algofoogle/gf180ws2rbz/README.md

# gf180ws2rbz: Raybox-zero supporting materials

For now, this is just a test PCB for various parts that could be used to support a raybox-zero devkit.
