algofoogle/gf180ws2rbz/docs/wafer_space_1x0p5_padring.pdf

# Wafer.Space GF180 Run 2 — Raybox Zero 1×0.5 Padring

## GDS-derived to-scale pad geometry · top view · TEX_PMOD_TYPE=1 mode

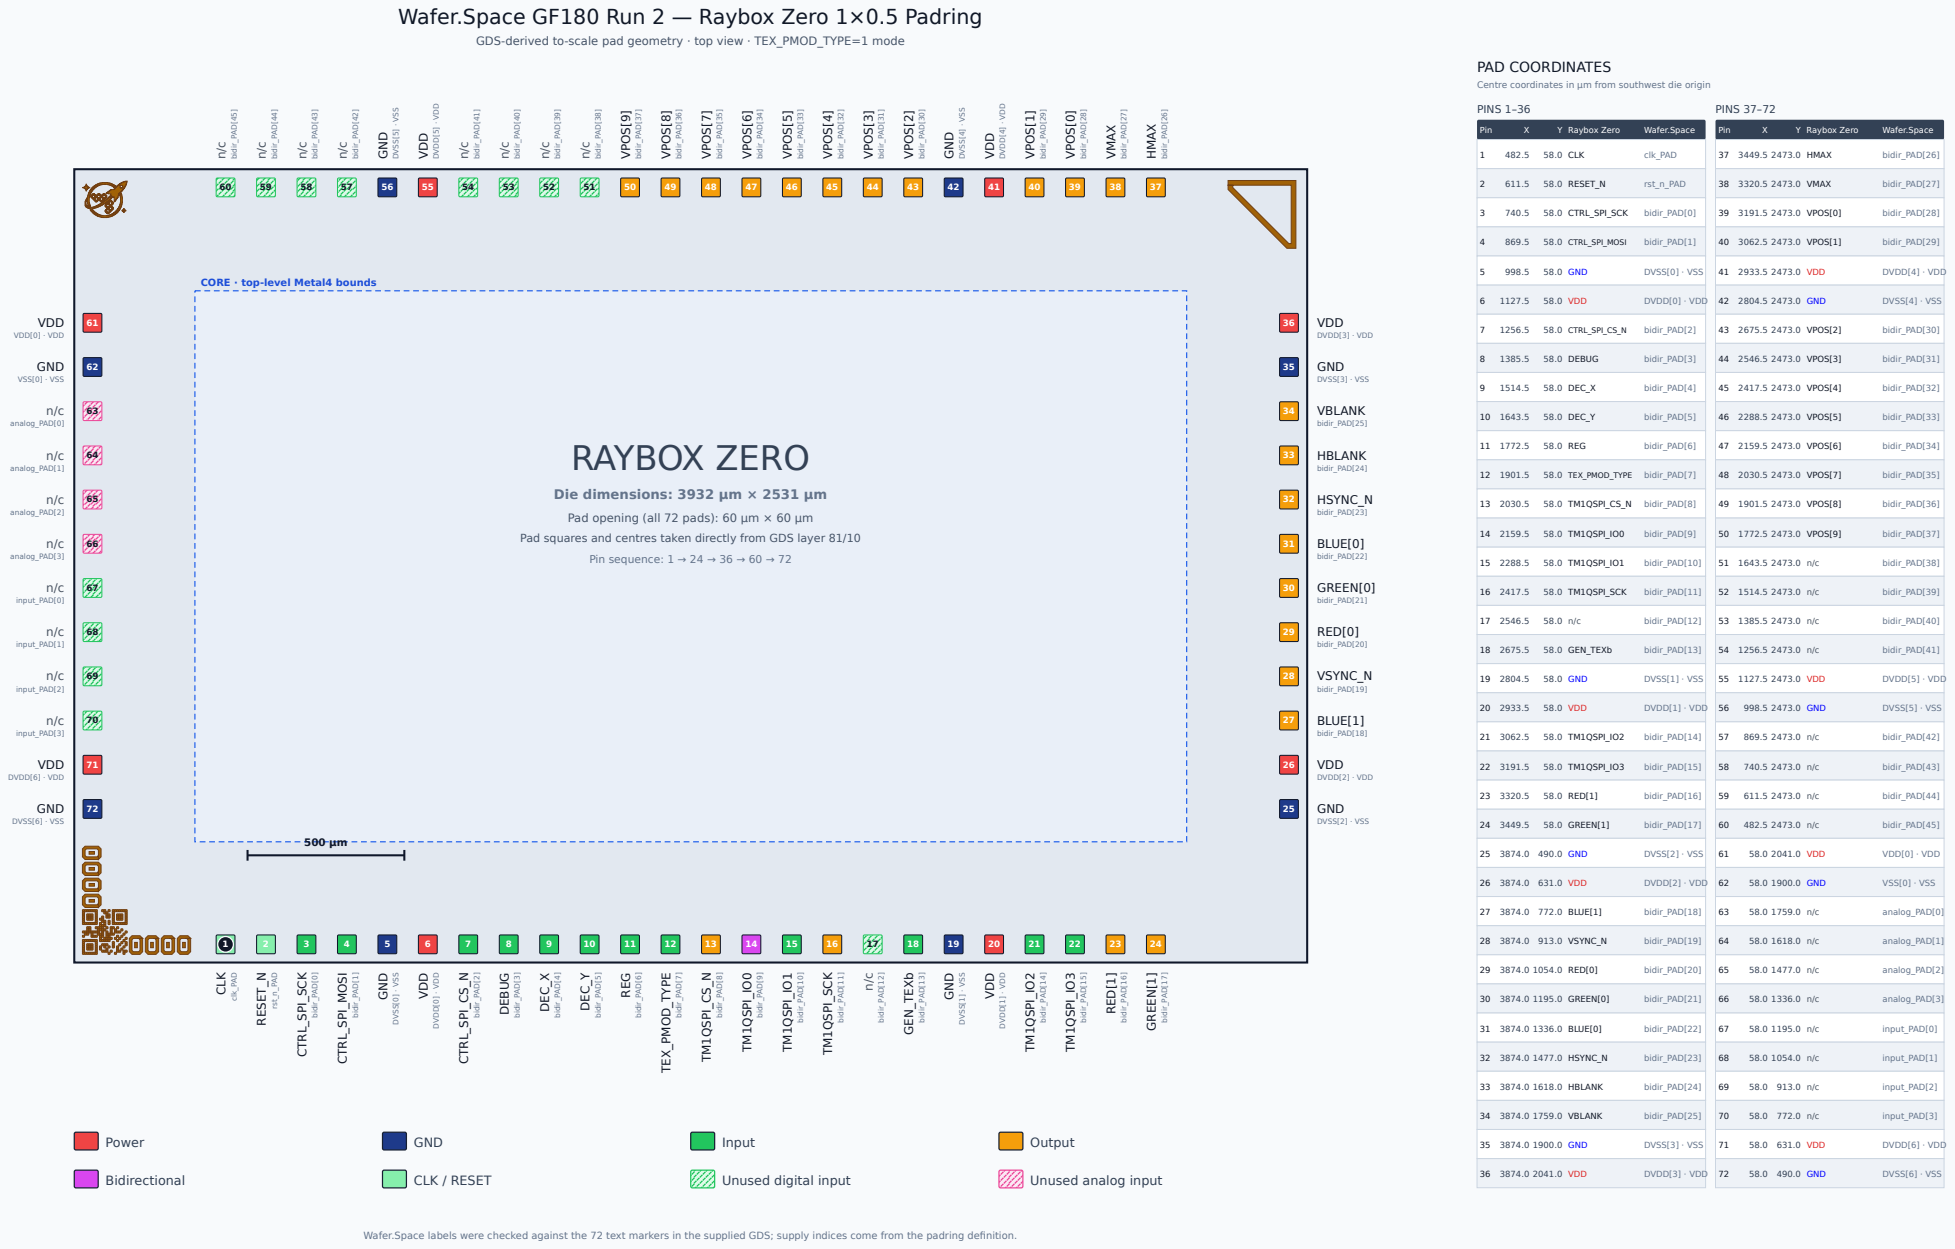
[picture p3: page 1]
1CLK; clk_PAD; 2RESET_N; rst_n_PAD; 3CTRL_SPI_SCK; bidir_PAD[0]; 4CTRL_SPI_MOSI; bidir_PAD[1]; 5GND; DVSS[0] · VSS; 6VDD; DVDD[0] · VDD; 7CTRL_SPI_CS_N; bidir_PAD[2]; 8DEBUG; bidir_PAD[3]; 9DEC_X; bidir_PAD[4]; 10DEC_Y bidir_PAD[5]; 11REG; bidir_PAD[6]; 12TEX_PMOD_TYPE; bidir_PAD[7]; 13TM¹QSPI_CS_N; bidir_PAD[8]; 14TM¹QSPI_IO⁰ bidir_PAD[9]; 15TM¹QSPI_IO¹; bidir_PAD[10]; 16TM¹QSPI_SCK bidir_PAD[11]; bidir_PAD[12]; 18GEN_TEXb; bidir_PAD[13]; 19GND; DVSS[1] · VSS; 20VDD DVDD[1] · VDD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

Centre coordinates in µm from southwest die origin

CORE · top-level Metal4 bounds

Die dimensions: 3932 µm × 2531 µm
Pad opening (all 72 pads): 60 µm × 60 µm

Pad squares and centres taken directly from GDS layer 81/10

Wafer.Space labels were checked against the 72 text markers in the supplied GDS; supply indices come from the padring definition.
