algofoogle/gf180ws2rbz/gf180ws2rbz_parts_test/gf180ws2rbz_parts_test.kicad_pcb

## KiCad design gf180ws2rbz_parts_test/gf180ws2rbz_parts_test.kicad_pcb (2026-11-12)

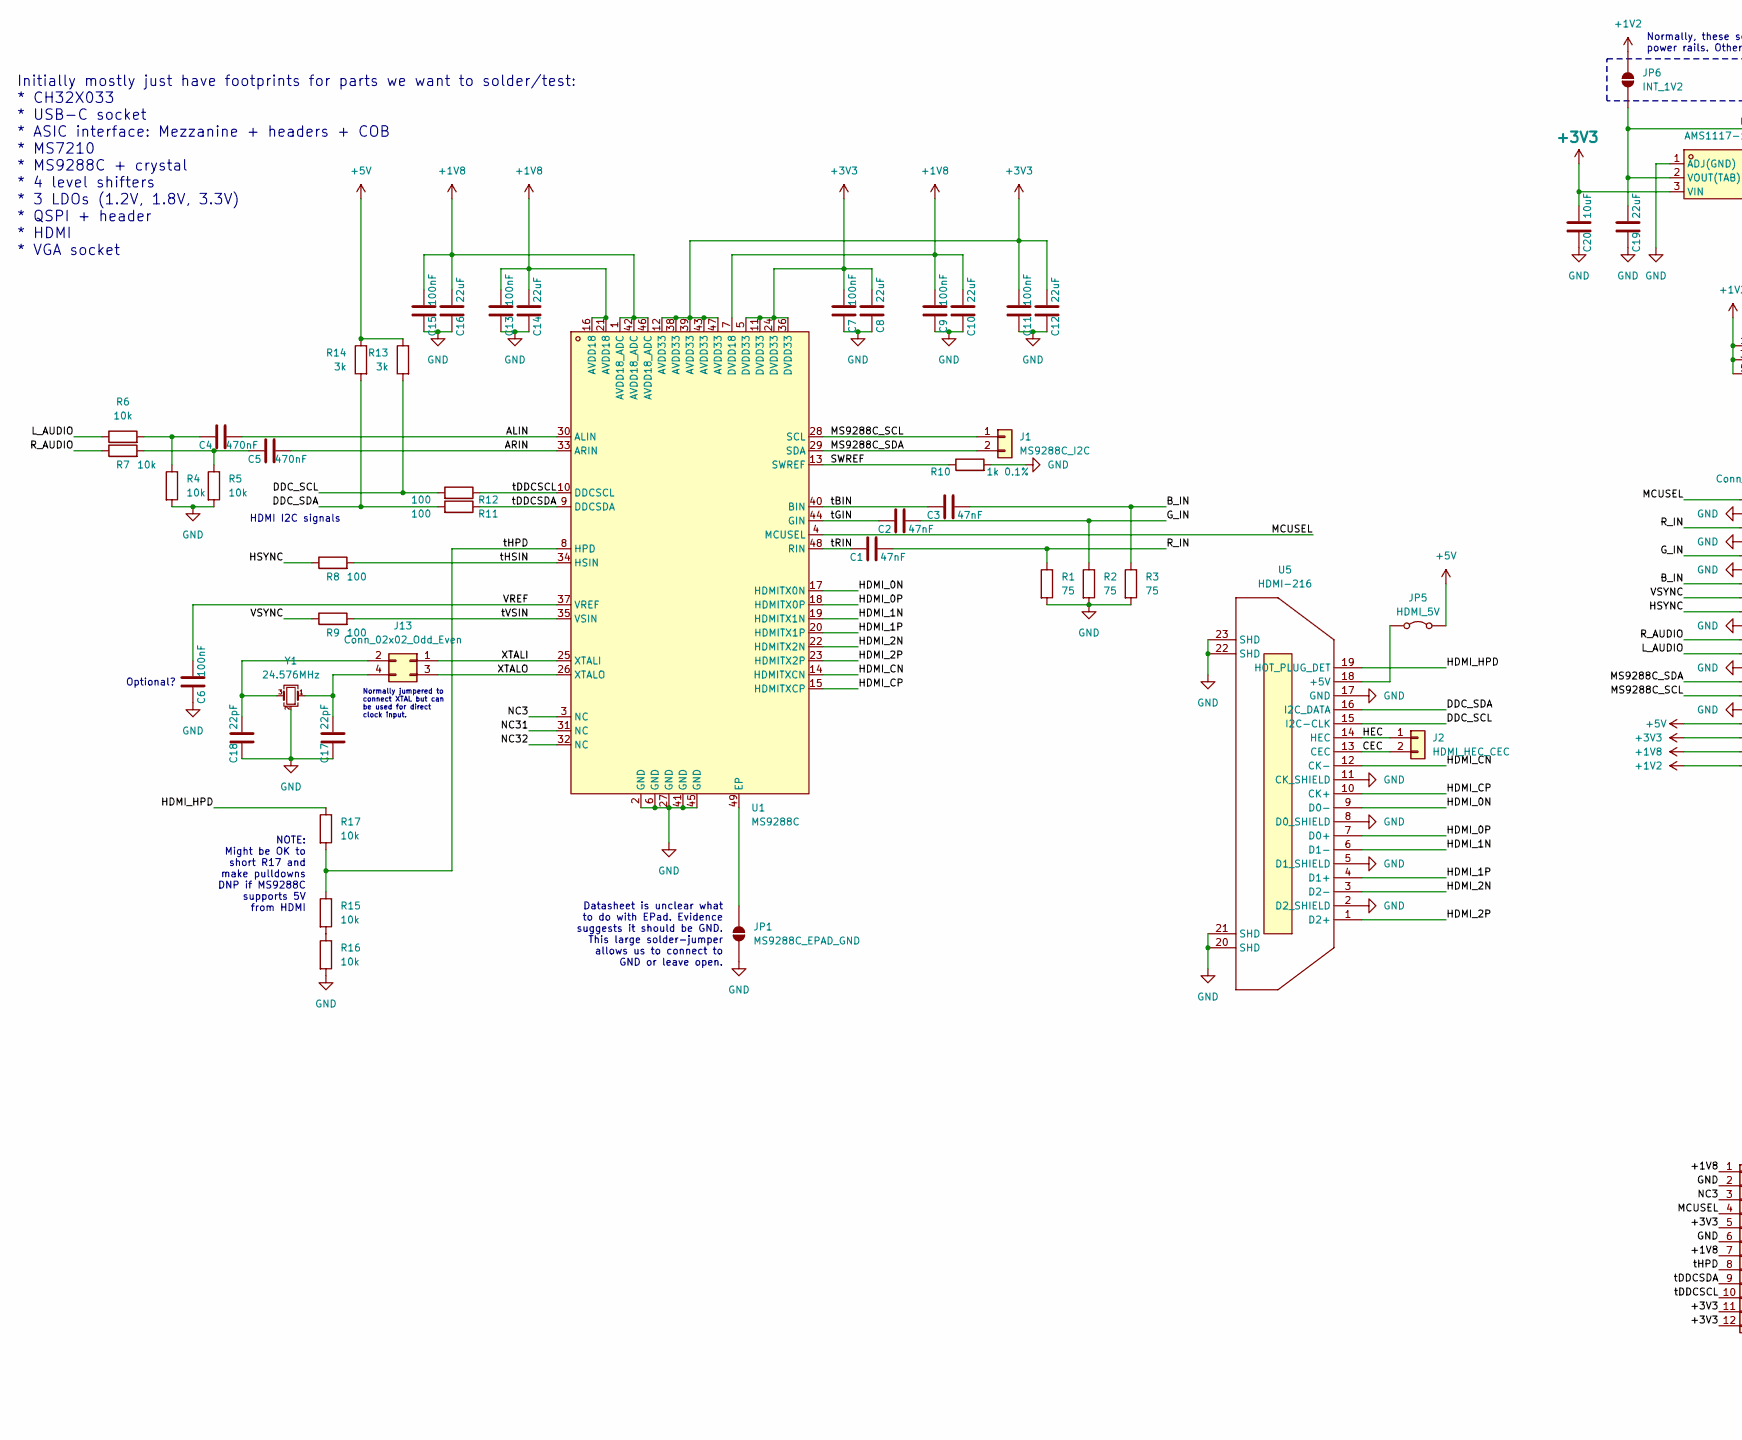
[picture p4: schematic gf180ws2rbz_parts_test.kicad_sch, part in row 1, column 1]

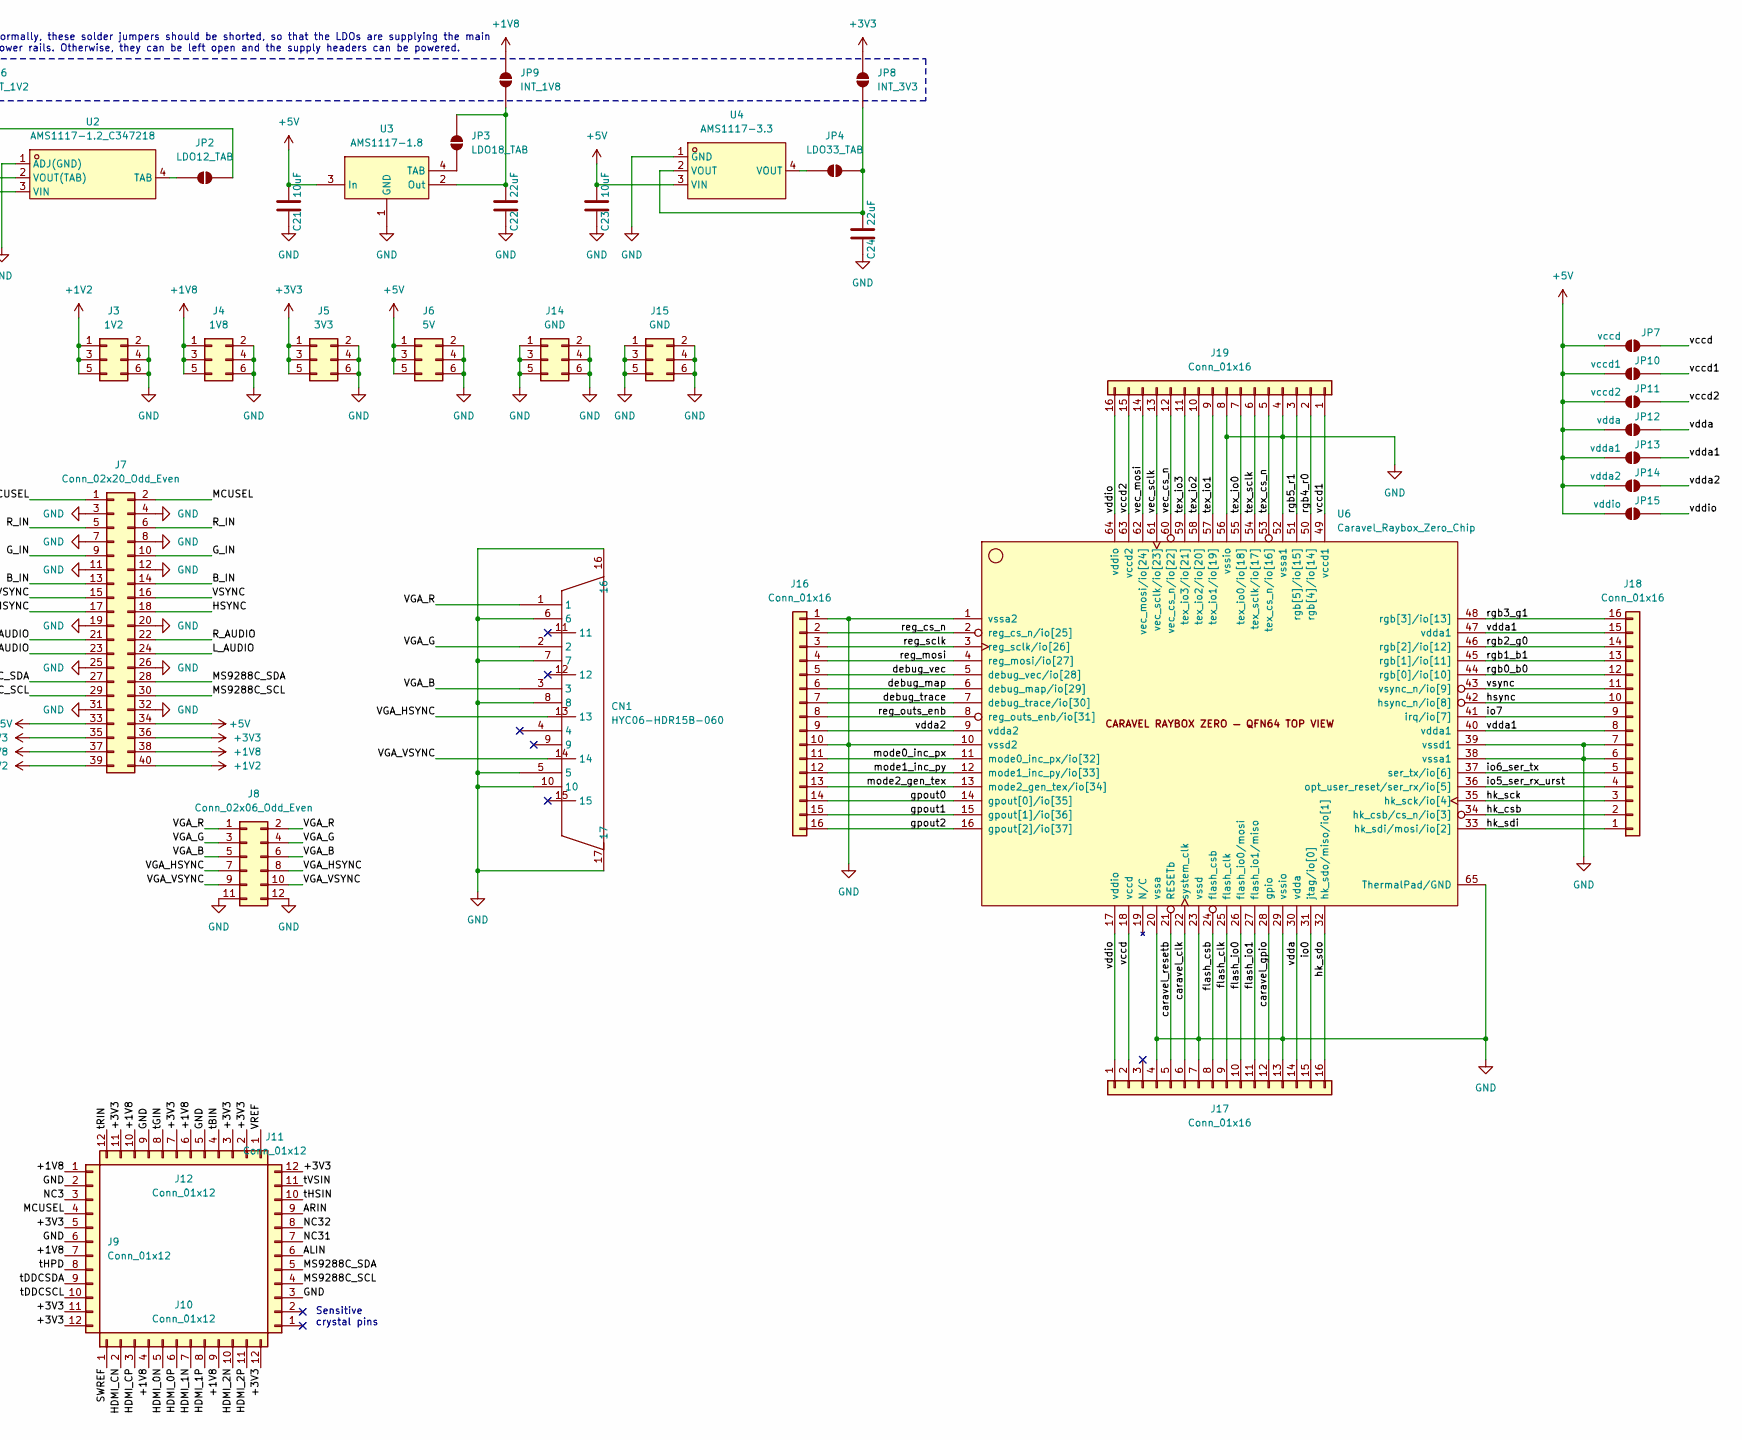
[picture p5: schematic gf180ws2rbz_parts_test.kicad_sch, part in row 1, column 2]

Parts:
C1, C2, C3: 47nF; C_0603_1608Metric_Pad1.08x0.95mm_HandSolder
C4, C5: 470nF; C_0603_1608Metric_Pad1.08x0.95mm_HandSolder
C6, C7, C9, C11, C13, C15: 100nF; C_0603_1608Metric_Pad1.08x0.95mm_HandSolder
C8, C10, C12, C14, C16, C19, C22, C24: 22uF; C_0603_1608Metric_Pad1.08x0.95mm_HandSolder
C17, C18: 22pF; C_0603_1608Metric_Pad1.08x0.95mm_HandSolder
C20, C21, C23: 10uF; C_0603_1608Metric_Pad1.08x0.95mm_HandSolder
CN1: HYC06-HDR15B-060; DSUB-TH_HYC06-HDR15B-060; MPN HYC06-HDR15B-060; LCSC Part C711364
J1: MS9288C_I2C; PinHeader_1x02_P2.54mm_Vertical
J2: HDMI_HEC_CEC; PinHeader_1x02_P2.54mm_Vertical
J3: 1V2; PinHeader_2x03_P2.54mm_Vertical
J4: 1V8; PinHeader_2x03_P2.54mm_Vertical
J5: 3V3; PinHeader_2x03_P2.54mm_Vertical
J6: 5V; PinHeader_2x03_P2.54mm_Vertical
J7: Conn_02x20_Odd_Even; PinHeader_2x20_P2.54mm_Vertical
J8: Conn_02x06_Odd_Even; PinHeader_2x06_P2.54mm_Vertical
J9, J10, J11, J12: Conn_01x12; AntonPTHTestPointStagger12way
J13: Conn_02x02_Odd_Even; Anton-PinSocket_2x02_P2.54mm_Vertical-SolderJumper
J14, J15: GND; PinHeader_2x03_P2.54mm_Vertical
J16, J17, J18, J19: Conn_01x16; Anton_Pads_01x16_1.27mm_Compact_SMD
JP1: MS9288C_EPAD_GND; SolderJumper-2_P1.3mm_Open_RoundedPad1.0x1.5mm
JP2: LDO12_TAB; SolderJumper-2_P1.3mm_Open_RoundedPad1.0x1.5mm
JP3: LDO18_TAB; SolderJumper-2_P1.3mm_Open_RoundedPad1.0x1.5mm
JP4: LDO33_TAB; SolderJumper-2_P1.3mm_Open_RoundedPad1.0x1.5mm
JP5: HDMI_5V; Anton-PinHeader_1x02_P2.54mm_Vertical-SolderJumper
JP6: INT_1V2; SolderJumper-2_P1.3mm_Open_RoundedPad1.0x1.5mm
JP7: vccd; SolderJumper-2_P1.3mm_Open_RoundedPad1.0x1.5mm
JP8: INT_3V3; SolderJumper-2_P1.3mm_Open_RoundedPad1.0x1.5mm
JP9: INT_1V8; SolderJumper-2_P1.3mm_Open_RoundedPad1.0x1.5mm
JP10: vccd1; SolderJumper-2_P1.3mm_Open_RoundedPad1.0x1.5mm
JP11: vccd2; SolderJumper-2_P1.3mm_Open_RoundedPad1.0x1.5mm
JP12: vdda; SolderJumper-2_P1.3mm_Open_RoundedPad1.0x1.5mm
JP13: vdda1; SolderJumper-2_P1.3mm_Open_RoundedPad1.0x1.5mm
JP14: vdda2; SolderJumper-2_P1.3mm_Open_RoundedPad1.0x1.5mm
JP15: vddio; SolderJumper-2_P1.3mm_Open_RoundedPad1.0x1.5mm
R1, R2, R3: 75; R_0603_1608Metric_Pad0.98x0.95mm_HandSolder
R4, R5, R6, R7, R15, R16, R17: 10k; R_0603_1608Metric_Pad0.98x0.95mm_HandSolder
R8, R9, R11, R12: 100; R_0603_1608Metric_Pad0.98x0.95mm_HandSolder
R10: 1k 0.1%; R_0603_1608Metric_Pad0.98x0.95mm_HandSolder
R13, R14: 3k; R_0603_1608Metric_Pad0.98x0.95mm_HandSolder
U1: MS9288C; Anton-QFN-48_L6-W6-P0.4-TL-EP4.2-HandSolder; MPN MS9288C; LCSC Part C2914316
U2: AMS1117-1.2_C347218; SOT-223_L6.7-W3.5-P2.30-BR; MPN AMS1117-1.2; LCSC Part C347218
U3: AMS1117-1.8; SOT-223-4_L6.5-W3.5-P2.30-LS7.0-BR; MPN AMS1117-1.8; LCSC Part C6185
U4: AMS1117-3.3; SOT-223-3_L6.5-W3.4-P2.30-LS7.0-BR; MPN AMS1117-3.3; LCSC Part C6186
U5: HDMI-216; HDMI-SMD_KH-HDMI-19P-CU; MPN HDMI-216; LCSC Part C2962407
U6: Caravel_Raybox_Zero_Chip; Anton-QFN-64-1EP_9x9mm_P0.5mm_EP7.65x7.65mm-HOLE
Y1: 24.576MHz; Crystal_SMD_EuroQuartz_MT-4Pin_3.2x2.5mm_HandSoldering; PartNum XTM32024576JT00351001; LCSC_PartNum C41383247

Connections:
+1V2: J3.1, J3.3, J3.5, J7.39, J7.40, JP6.1 (A)
+1V8: C9.2, C10.2, C13.2, C14.2, C15.2, C16.2, J4.1, J4.3, J4.5, J7.37, J7.38, J9.1, J9.7, J10.4, J10.9, J12.6, J12.10, JP9.1 (A), U1.1 (AVDD18_ADC), U1.7 (DVDD18), U1.16 (AVDD18), U1.21 (AVDD18), U1.42 (AVDD18_ADC), U1.46 (AVDD18_ADC)
+3V3: C7.2, C8.2, C11.2, C12.2, C20.2, J5.1, J5.3, J5.5, J7.35, J7.36, J9.5, J9.11, J9.12, J10.12, J11.12, J12.2, J12.3, J12.7, J12.11, JP8.1 (A), U1.5 (DVDD33), U1.11 (DVDD33), U1.12 (AVDD33), U1.24 (DVDD33), U1.36 (DVDD33), U1.38 (AVDD33), U1.39 (AVDD33), U1.43 (AVDD33), U1.47 (AVDD33), U2.3 (VIN)
/ALIN: C4.2, J11.6, U1.30 (ALIN)
/ARIN: C5.2, J11.9, U1.33 (ARIN)
/CEC: J2.2, U5.13 (CEC)
/DDC_SCL: R12.2, R13.2, U5.15 (I2C-CLK)
/DDC_SDA: R11.2, R14.2, U5.16 (I2C_DATA)
/HDMI_0N: J10.5, U1.17 (HDMITX0N), U5.9 (D0-)
/HDMI_0P: J10.6, U1.18 (HDMITX0P), U5.7 (D0+)
/HDMI_1N: J10.7, U1.19 (HDMITX1N), U5.6 (D1-)
/HDMI_1P: J10.8, U1.20 (HDMITX1P), U5.4 (D1+)
/HDMI_2N: J10.10, U1.22 (HDMITX2N), U5.3 (D2-)
/HDMI_2P: J10.11, U1.23 (HDMITX2P), U5.1 (D2+)
/HDMI_CN: J10.2, U1.14 (HDMITXCN), U5.12 (CK-)
/HDMI_CP: J10.3, U1.15 (HDMITXCP), U5.10 (CK+)
/HDMI_HPD: R17.1, U5.19 (HOT_PLUG_DET)
/HEC: J2.1, U5.14 (HEC)
/HSYNC: J7.17, J7.18, R8.1; also elsewhere on the board
/L_AUDIO: J7.23, J7.24, R6.1
/MCUSEL: J7.1, J7.2, J9.4, U1.4 (MCUSEL)
/MS9288C_SCL: J1.1, J7.29, J7.30, J11.4, U1.28 (SCL)
/MS9288C_SDA: J1.2, J7.27, J7.28, J11.5, U1.29 (SDA)
/NC3: J9.3, U1.3 (NC)
/NC31: J11.7, U1.31 (NC)
/NC32: J11.8, U1.32 (NC)
/R_AUDIO: J7.21, J7.22, R7.1
/SWREF: J10.1, R10.1, U1.13 (SWREF)
/VGA_HSYNC: CN1.13, J8.7, J8.8; also elsewhere on the board
/VGA_VSYNC: CN1.14, J8.9, J8.10; also elsewhere on the board
/VREF: C6.2, J12.1, U1.37 (VREF)
/VSYNC: J7.15, J7.16, R9.1; also elsewhere on the board
/XTALI: J13.1, U1.25 (XTALI)
/XTALO: J13.3, U1.26 (XTALO)
/caravel_clk: J17.6, U6.22 (system_clk)
/caravel_gpio: J17.12, U6.28 (gpio)
/caravel_resetb: J17.5, U6.21 (RESETb)
/debug_map: J16.6, U6.6 (debug_map/io[29])
/debug_trace: J16.7, U6.7 (debug_trace/io[30])
/debug_vec: J16.5, U6.5 (debug_vec/io[28])
/flash_clk: J17.9, U6.25 (flash_clk)
/flash_csb: J17.8, U6.24 (flash_csb)
/flash_io0: J17.10, U6.26 (flash_io0/mosi)
/flash_io1: J17.11, U6.27 (flash_io1/miso)
/gpout0: J16.14, U6.14 (gpout[0]/io[35])
/gpout1: J16.15, U6.15 (gpout[1]/io[36])
/gpout2: J16.16, U6.16 (gpout[2]/io[37])
/hk_csb: J18.2, U6.34 (hk_csb/cs_n/io[3])
/hk_sck: J18.3, U6.35 (hk_sck/io[4])
/hk_sdi: J18.1, U6.33 (hk_sdi/mosi/io[2])
/hk_sdo: J17.16, U6.32 (hk_sdo/miso/io[1])
/hsync: J18.10, U6.42 (hsync_n/io[8])
/io0: J17.15, U6.31 (jtag/io[0])
/io5_ser_rx_urst: J18.4, U6.36 (opt_user_reset/ser_rx/io[5])
/io6_ser_tx: J18.5, U6.37 (ser_tx/io[6])
/io7: J18.9, U6.41 (irq/io[7])
/mode0_inc_px: J16.11, U6.11 (mode0_inc_px/io[32])
/mode1_inc_py: J16.12, U6.12 (mode1_inc_py/io[33])
/mode2_gen_tex: J16.13, U6.13 (mode2_gen_tex/io[34])
/reg_cs_n: J16.2, U6.2 (reg_cs_n/io[25])
/reg_mosi: J16.4, U6.4 (reg_mosi/io[27])
/reg_outs_enb: J16.8, U6.8 (reg_outs_enb/io[31])
/reg_sclk: J16.3, U6.3 (reg_sclk/io[26])
/rgb0_b0: J18.12, U6.44 (rgb[0]/io[10])
/rgb1_b1: J18.13, U6.45 (rgb[1]/io[11])
/rgb2_g0: J18.14, U6.46 (rgb[2]/io[12])
/rgb3_g1: J18.16, U6.48 (rgb[3]/io[13])
/rgb4_r0: J19.2, U6.50 (rgb[4]/io[14])
/rgb5_r1: J19.3, U6.51 (rgb[5]/io[15])
/tBIN: C3.1, J12.4, U1.40 (BIN)
/tDDCSCL: J9.10, R12.1, U1.10 (DDCSCL)
/tDDCSDA: J9.9, R11.1, U1.9 (DDCSDA)
/tGIN: C2.1, J12.8, U1.44 (GIN)
/tHPD: J9.8, R15.1, R17.2, U1.8 (HPD)
/tHSIN: J11.10, R8.2, U1.34 (HSIN)
/tRIN: C1.1, J12.12, U1.48 (RIN)
/tVSIN: J11.11, R9.2, U1.35 (VSIN)
/tex_cs_n: J19.5, U6.53 (tex_cs_n/io[16])
/tex_io0: J19.7, U6.55 (tex_io0/io[18])
/tex_io1: J19.9, U6.57 (tex_io1/io[19])
/tex_io2: J19.10, U6.58 (tex_io2/io[20])
/tex_io3: J19.11, U6.59 (tex_io3/io[21])
/tex_sclk: J19.6, U6.54 (tex_sclk/io[17])
/vdda: J17.14, JP12.1 (A), U6.30 (vdda)
/vdda1: J18.8, J18.15, JP13.1 (A), U6.40 (vdda1), U6.47 (vdda1)
/vdda2: J16.9, JP14.1 (A), U6.9 (vdda2)
/vddio: J17.1, J19.16, JP15.1 (A), U6.17 (vddio), U6.64 (vddio)
/vec_cs_n: J19.12, U6.60 (vec_cs_n/io[22])
/vec_mosi: J19.14, U6.62 (vec_mosi/io[24])
/vec_sclk: J19.13, U6.61 (vec_sclk/io[23])
/vsync: J18.11, U6.43 (vsync_n/io[9])
GND: C6.1, C7.1, C8.1, C9.1, C10.1, C11.1, C12.1, C13.1, C14.1, C15.1, C16.1, C17.1, C18.1, C19.1, C20.1, C21.1, C22.1, C23.1, C24.1, CN1.5, CN1.6, CN1.7, CN1.8, CN1.10, CN1.16, CN1.17, J3.2, J3.4, J3.6, J4.2, J4.4, J4.6, J5.2, J5.4, J5.6, J6.2, J6.4, J6.6, J7.3, J7.4, J7.7, J7.8, J7.11, J7.12, J7.19, J7.20, J7.25, J7.26, J7.31, J7.32, J8.11, J8.12, J9.2, J9.6, J11.3, J12.5, J12.9, J14.1, J14.2, J14.3, J14.4, J14.5, J14.6, J15.1, J15.2, J15.3, J15.4, J15.5, J15.6, J16.1, J16.10, J17.4, J17.7, J17.13, J18.6, J18.7, J19.4, J19.8, JP1.1 (A), R1.2, R2.2, R3.2, R4.2, R5.2, R10.2, R16.2, U1.2 (GND), U1.6 (GND), U1.27 (GND), U1.41 (GND), U1.45 (GND), U2.1 (ADJ(GND)), U3.1 (GND), U4.1 (GND), U5.2 (D2_SHIELD), U5.5 (D1_SHIELD), U5.8 (D0_SHIELD), U5.11 (CK_SHIELD), U5.17 (GND), U5.20 (SHD), U5.21 (SHD), U5.22 (SHD), U5.23 (SHD), U6.1 (vssa2), U6.10 (vssd2), U6.20 (vssa), U6.23 (vssd), U6.29 (vssio), U6.38 (vssa1), U6.39 (vssd1), U6.52 (vssa1), U6.56 (vssio), U6.65 (ThermalPad/GND), Y1.2 (G), Y1.4 (G)
unnamed: C4.1, R4.1, R6.2
unnamed: C5.1, R5.1, R7.2
unnamed: C18.2, J13.2, Y1.3
unnamed: C17.2, J13.4, Y1.1
unnamed: JP1.2 (B), U1.49 (EP)
unnamed: C19.2, JP2.1 (A), JP6.2 (B), U2.2 (VOUT(TAB))
unnamed: JP2.2 (B), U2.4 (TAB)
unnamed: C22.2, JP3.1 (A), JP9.2 (B), U3.2 (Out)
unnamed: JP3.2 (B), U3.4 (TAB)
unnamed: C24.2, JP4.1 (A), JP8.2 (B), U4.2 (VOUT)
unnamed: JP4.2 (B), U4.4 (VOUT)
unnamed: JP5.1 (A), U5.18 (+5V)
unnamed: R15.2, R16.1

Notes on the sheet:
Normally, these solder jumpers should be shorted, so that the LDOs are supplying the main power rails. Otherwise, they can be left open and the supply headers can be powered.
Normally jumpered to connect XTAL but can be used for direct clock input.
Sensitive crystal pins
Optional?
Datasheet is unclear what to do with EPad. Evidence suggests it should be GND. This large solder-jumper allows us to connect to GND or leave open.
HDMI I2C signals
Initially mostly just have footprints for parts we want to solder/test: * CH32X033 * USB-C socket * ASIC interface: Mezzanine + headers + COB * MS7210 * MS9288C + crystal * 4 level shifters * 3 LDOs (1.2V, 1.8V, 3.3V) * QSPI + header * HDMI * VGA socket
NOTE: Might be OK to short R17 and make pulldowns DNP if MS9288C supports 5V from HDMI

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
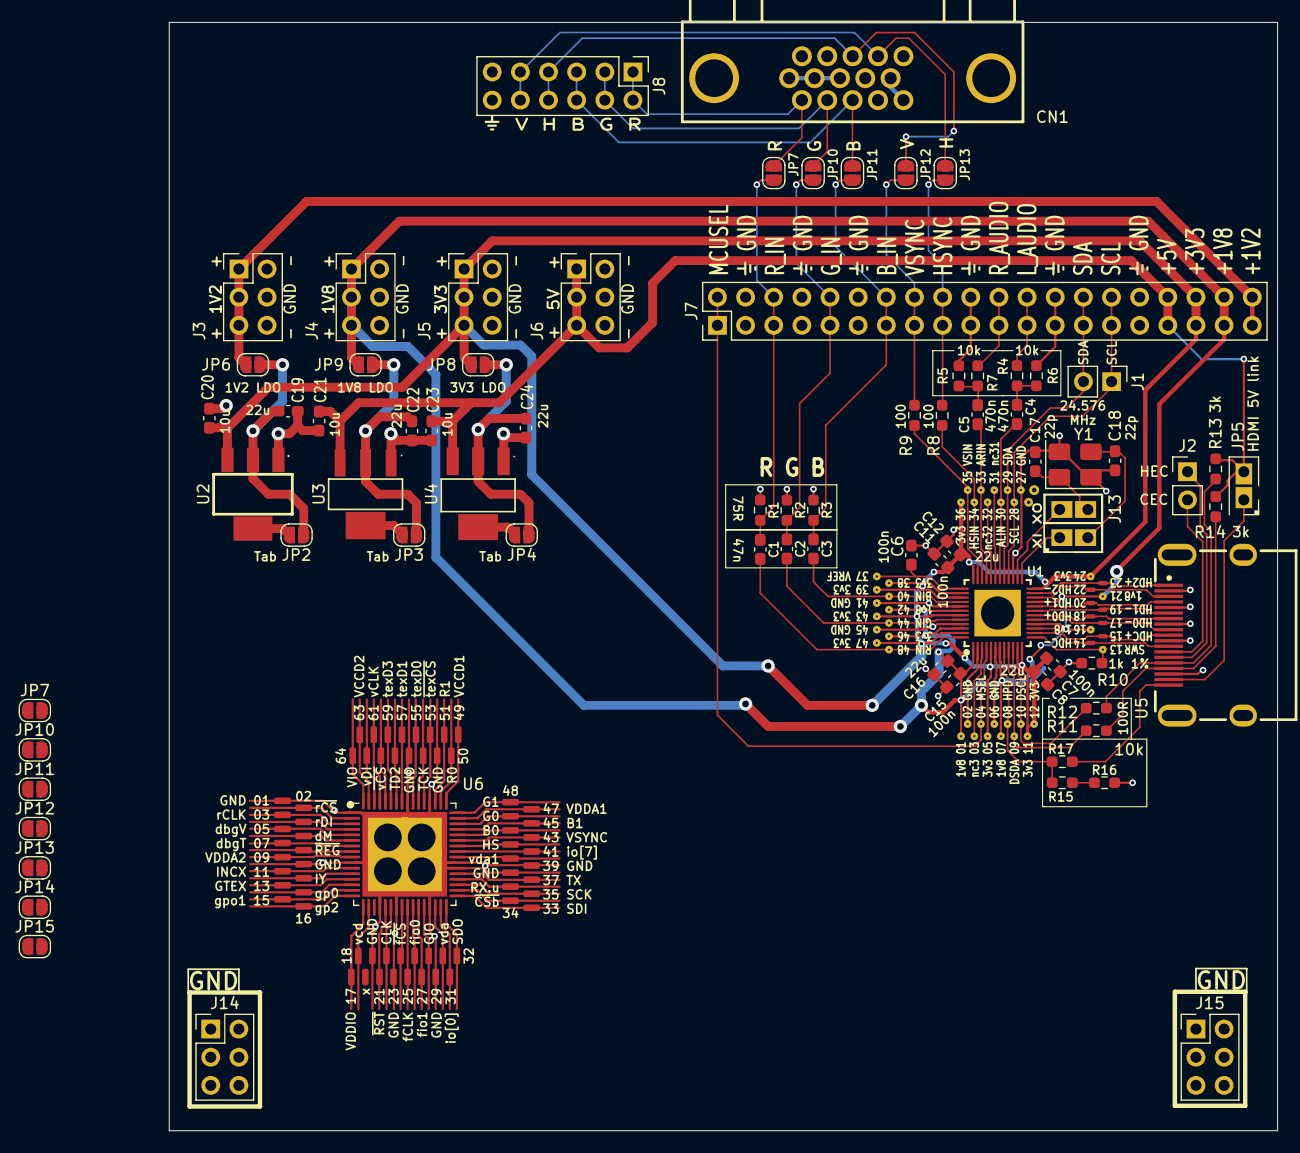
[picture p6: board gf180ws2rbz_parts_test.kicad_pcb from above]

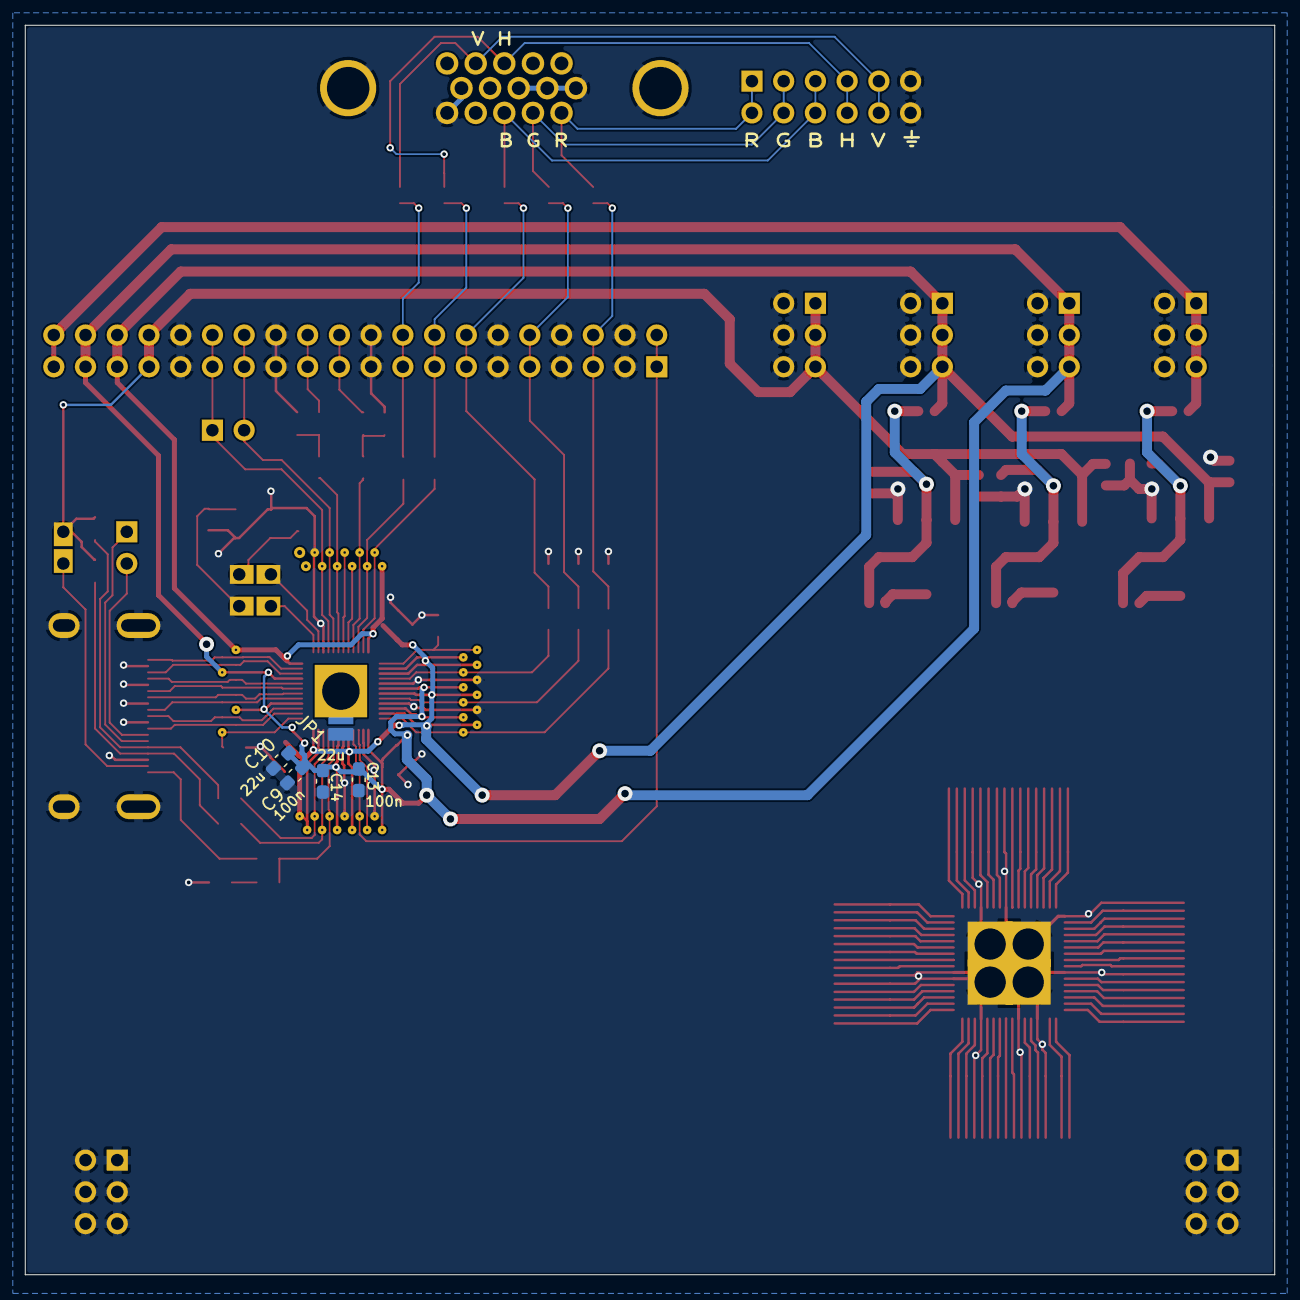
[picture p7: board gf180ws2rbz_parts_test.kicad_pcb from below]

Board: 2 copper layers, 100.0 x 100.0 mm, 88 parts (5 on the bottom side), 115 nets.

Other parts of the board:
JP7#2: vccd; SolderJumper-2_P1.3mm_Open_RoundedPad1.0x1.5mm
JP10#2: vccd1; SolderJumper-2_P1.3mm_Open_RoundedPad1.0x1.5mm
JP11#2: vccd2; SolderJumper-2_P1.3mm_Open_RoundedPad1.0x1.5mm
JP12#2, JP13#2: SolderJumper-2_P1.3mm_Open_RoundedPad1.0x1.5mm

Their connections:
/HSYNC: JP13#2.2 (B); also elsewhere on the board
/VGA_HSYNC: JP12#2.1 (A); also elsewhere on the board
/VGA_VSYNC: JP13#2.1 (A); also elsewhere on the board
/VSYNC: JP12#2.2 (B); also elsewhere on the board
