algofoogle/gf180ws2rbz/(commit log)

2026-11-02 Initial commit
    Basic test PCB for MS9288C
    [gf180ws2rbz_parts_test.kicad_pcb, gf180ws2rbz_parts_test.kicad_sch]
2026-11-04 Test point arrays. PCB started. Minor tweaks
    [gf180ws2rbz_parts_test.kicad_pcb, gf180ws2rbz_parts_test.kicad_sch]
2026-11-05 PCB layout WIP (HDMI, EPad, Xtal jumpers)
    [gf180ws2rbz_parts_test.kicad_pcb, gf180ws2rbz_parts_test.kicad_sch]
2026-11-05 More layout WIP
    [gf180ws2rbz_parts_test.kicad_pcb, gf180ws2rbz_parts_test.kicad_sch]
2026-11-06 Layout WIP: Power, test header, more MS9288C core
    [gf180ws2rbz_parts_test.kicad_pcb, gf180ws2rbz_parts_test.kicad_sch]
2026-11-08 MS9288C layout nearly done. Some 'Anton' footprints updated
    [gf180ws2rbz_parts_test.kicad_pcb, gf180ws2rbz_parts_test.kicad_sch]
2026-11-08 MS9288C layout v0.9 done
    [gf180ws2rbz_parts_test.kicad_pcb]
2026-11-08 DRC cleanup
    [gf180ws2rbz_parts_test.kicad_pcb]
2026-11-09 Starting to add Caravel/GFMPW1 Raybox Zero
    [gf180ws2rbz_parts_test.kicad_pcb, gf180ws2rbz_parts_test.kicad_sch]
2026-11-09 Tidy up GFMPW1 reference stuff
    [gf180ws2rbz_parts_test.kicad_pcb, gf180ws2rbz_parts_test.kicad_sch]
2026-11-10 Compact Caravel test pad breakouts
    [gf180ws2rbz_parts_test.kicad_pcb, gf180ws2rbz_parts_test.kicad_sch]
2026-11-11 Minor updates
    [gf180ws2rbz_parts_test.kicad_pcb, gf180ws2rbz_parts_test.kicad_sch]
2026-11-11 More minor updates
    [gf180ws2rbz_parts_test.kicad_pcb]
2026-11-12 Still more minor updates + first cut of AI handoff ZIP
    [gf180ws2rbz_parts_test.kicad_pcb]
